vaexey/oracle/README.md

# oracle
PDA device concept  
  
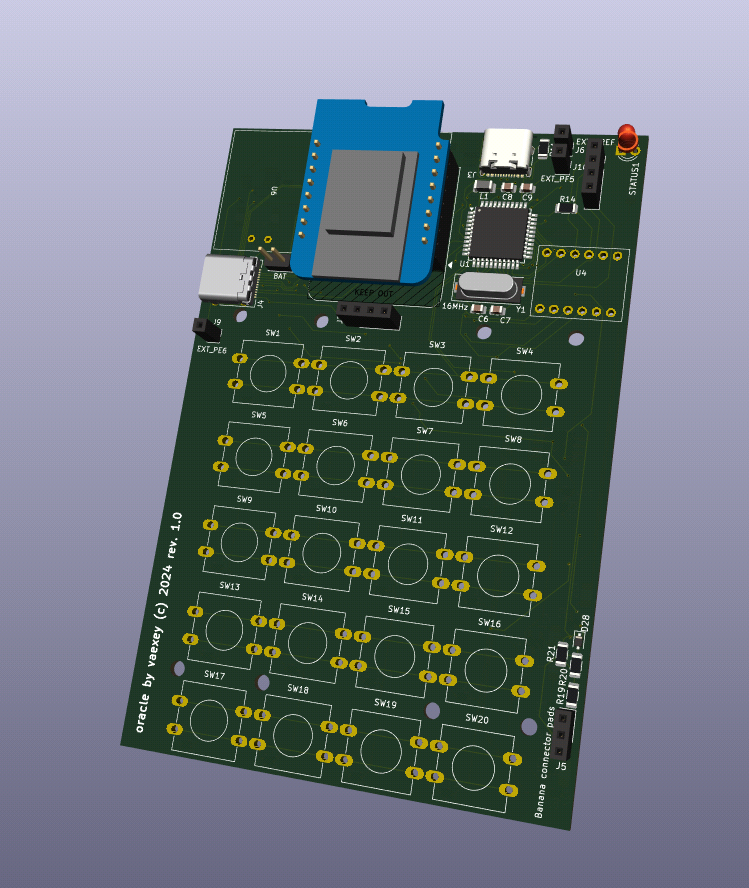
[picture p1: docs/oracle_3d_image.png]
3D image
  
  
`TODO: README`
