vaexey/oracle/docs/proprietary/SOURCE.md

# Proprietary datasheets
All files posted here are licensed under different license than the repository one.  
Seek for the licensing information at the respectful owners' side.  

## Datasheets
 - [ATmega32U4](https://ww1.microchip.com/downloads/en/devicedoc/atmel-7766-8-bit-avr-atmega16u4-32u4_datasheet.pdf)
 - [WEMOS D1 MINI schematic](https://www.wemos.cc/en/latest/_static/files/sch_d1_mini_v3.0.0.pdf)
 - [TI NE5532](https://www.ti.com/lit/ds/symlink/ne5532.pdf)
