vaexey/oracle/docs/keypad.pdf

1

2

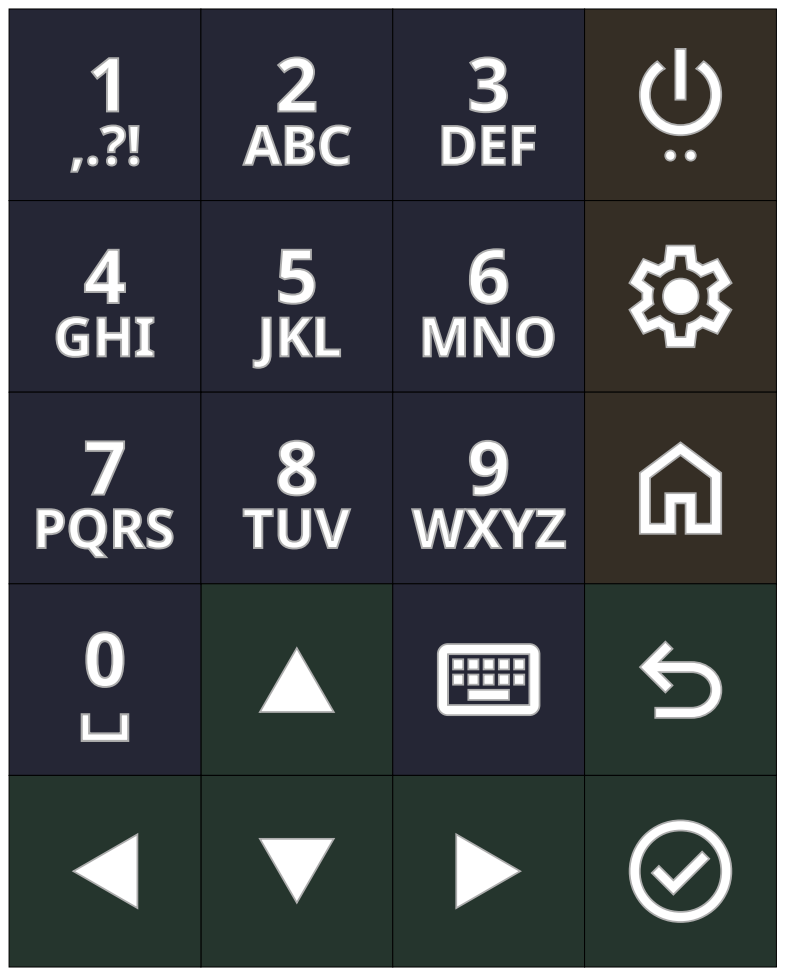
[picture p6: page 1]
ABC; 3 DEF; 4 GHI; 5 JKL; 6 MNO; 7 PQRS; 8 TUV; 9 WXYZ
