vaexey/oracle/docs/pcb_v.1.0.pdf

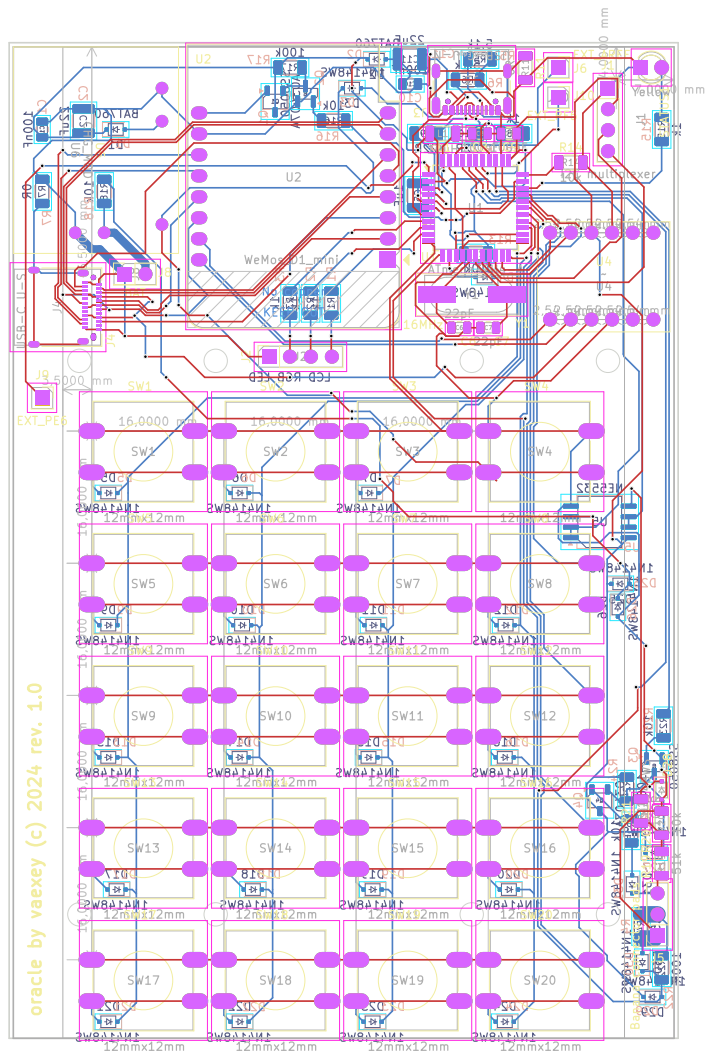
[picture p7: page 1]
