vaexey/oracle/oracle/oracle.kicad_pcb

## KiCad design oracle/oracle.kicad_pcb (2024-11-30)

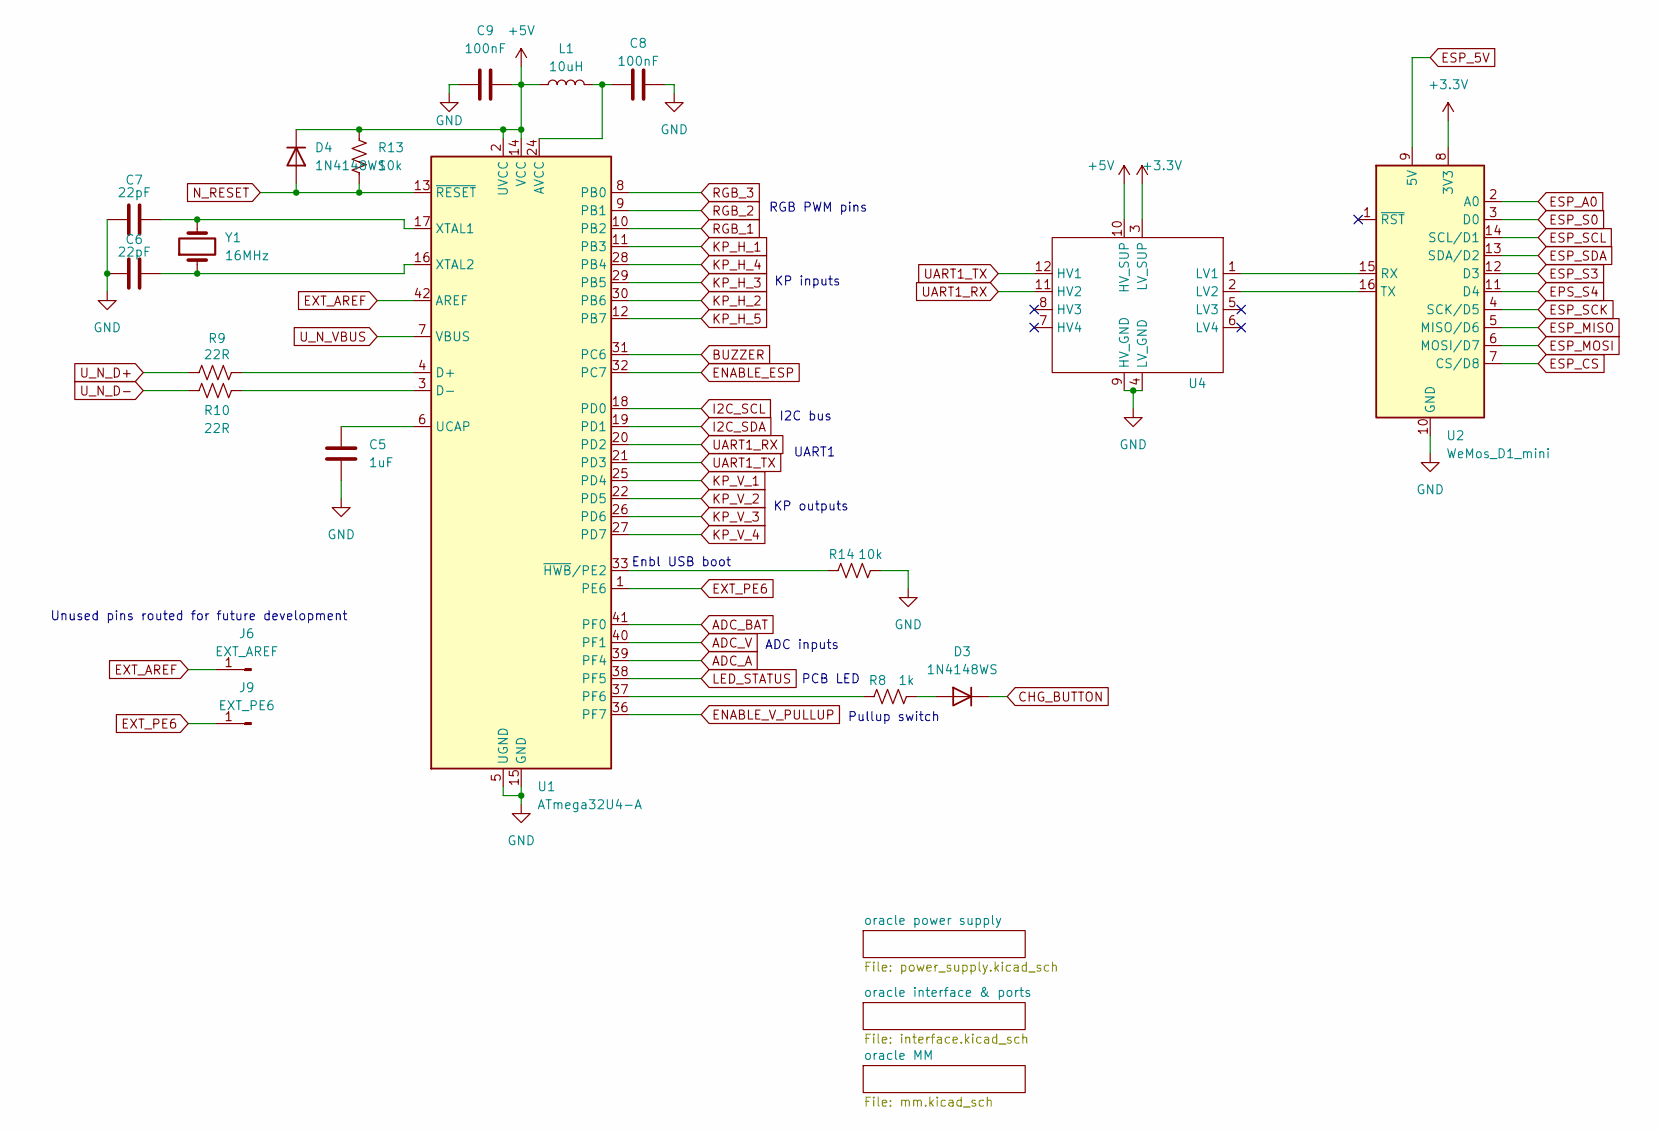
[picture p8: schematic oracle.kicad_sch, oracle root]

Parts:
C5: 1uF; C_1210_3225Metric
C6, C7: 22pF; C_0805_2012Metric
C8, C9: 100nF; C_0805_2012Metric
D3, D4: 1N4148WS; D_SOD-323F
J6: EXT_AREF; PinSocket_1x01_P2.54mm_Vertical
J9: EXT_PE6; PinSocket_1x01_P2.54mm_Vertical
L1: 10uH; L_1206_3216Metric
R8: 1k; R_1206_3216Metric
R9, R10: 22R; R_1206_3216Metric
R13, R14: 10k; R_1206_3216Metric
U1: ATmega32U4-A; TQFP-44_10x10mm_P0.8mm
U2: WeMos_D1_mini; WEMOS_D1_mini_light
U4: 4ch_level_shifter_v1
Y1: 16MHz; Crystal_SMD_HC49-SD

Connections:
+3.3V: U2.8 (3V3), U4.3 (LV_SUP)
+5V: C9.2, D4.1 (K), L1.1, R13.1, U1.2 (UVCC), U1.14 (VCC), U1.34 (VCC), U4.10 (HV_SUP); also elsewhere on the board
ADC_A: U1.39 (PF4); also elsewhere on the board
ADC_BAT: U1.41 (PF0); also elsewhere on the board
ADC_V: U1.40 (PF1); also elsewhere on the board
BUZZER: U1.31 (PC6); also elsewhere on the board
CHG_BUTTON: D3.1 (K); also elsewhere on the board
ENABLE_ESP: U1.32 (PC7); also elsewhere on the board
ENABLE_V_PULLUP: U1.36 (PF7); also elsewhere on the board
EPS_S4: U2.11 (D4); also elsewhere on the board
ESP_5V: U2.9 (5V); also elsewhere on the board
ESP_A0: U2.2 (A0); also elsewhere on the board
ESP_CS: U2.7 (CS/D8); also elsewhere on the board
ESP_MISO: U2.5 (MISO/D6); also elsewhere on the board
ESP_MOSI: U2.6 (MOSI/D7); also elsewhere on the board
ESP_S0: U2.3 (D0); also elsewhere on the board
ESP_S3: U2.12 (D3); also elsewhere on the board
ESP_SCK: U2.4 (SCK/D5); also elsewhere on the board
ESP_SCL: U2.14 (SCL/D1); also elsewhere on the board
ESP_SDA: U2.13 (SDA/D2); also elsewhere on the board
EXT_AREF: J6.1, U1.42 (AREF)
EXT_PE6: J9.1, U1.1 (PE6)
GND: C5.2, C6.1, C7.1, C8.2, C9.1, R14.2, U1.5 (UGND), U1.15 (GND), U1.23 (GND), U1.35 (GND), U1.43 (GND), U2.10 (GND), U4.4 (LV_GND), U4.9 (HV_GND); also elsewhere on the board
I2C_SCL: U1.18 (PD0); also elsewhere on the board
I2C_SDA: U1.19 (PD1); also elsewhere on the board
KP_H_1: U1.11 (PB3); also elsewhere on the board
KP_H_2: U1.30 (PB6); also elsewhere on the board
KP_H_3: U1.29 (PB5); also elsewhere on the board
KP_H_4: U1.28 (PB4); also elsewhere on the board
KP_H_5: U1.12 (PB7); also elsewhere on the board
KP_V_1: U1.25 (PD4); also elsewhere on the board
KP_V_2: U1.22 (PD5); also elsewhere on the board
KP_V_3: U1.26 (PD6); also elsewhere on the board
KP_V_4: U1.27 (PD7); also elsewhere on the board
LED_STATUS: U1.38 (PF5); also elsewhere on the board
N_RESET: D4.2 (A), R13.2, U1.13 (~RESET)
unnamed: C8.1, L1.2, U1.24 (AVCC), U1.44 (AVCC)
unnamed: D3.2 (A), R8.2
unnamed: R9.2, U1.4 (D+)
unnamed: R10.2, U1.3 (D-)
unnamed: R8.1, U1.37 (PF6)
unnamed: C5.1, U1.6 (UCAP)
unnamed: C7.2, U1.17 (XTAL1), Y1.2
unnamed: C6.2, U1.16 (XTAL2), Y1.1
unnamed: R14.1, U1.33 (~HWB/PE2)
unnamed: U2.15 (RX), U4.1 (LV1)
unnamed: U2.16 (TX), U4.2 (LV2)
RGB_1: U1.10 (PB2); also elsewhere on the board
RGB_2: U1.9 (PB1); also elsewhere on the board
RGB_3: U1.8 (PB0); also elsewhere on the board
UART1_RX: U1.20 (PD2), U4.11 (HV2)
UART1_TX: U1.21 (PD3), U4.12 (HV1)
U_N_D+: R9.1; also elsewhere on the board
U_N_D-: R10.1; also elsewhere on the board
U_N_VBUS: U1.7 (VBUS); also elsewhere on the board

Notes on the sheet:
RGB PWM pins
Pullup switch
ADC inputs
Unused pins routed for future development
I2C bus
KP outputs
KP inputs
UART1
PCB LED
Enbl USB boot

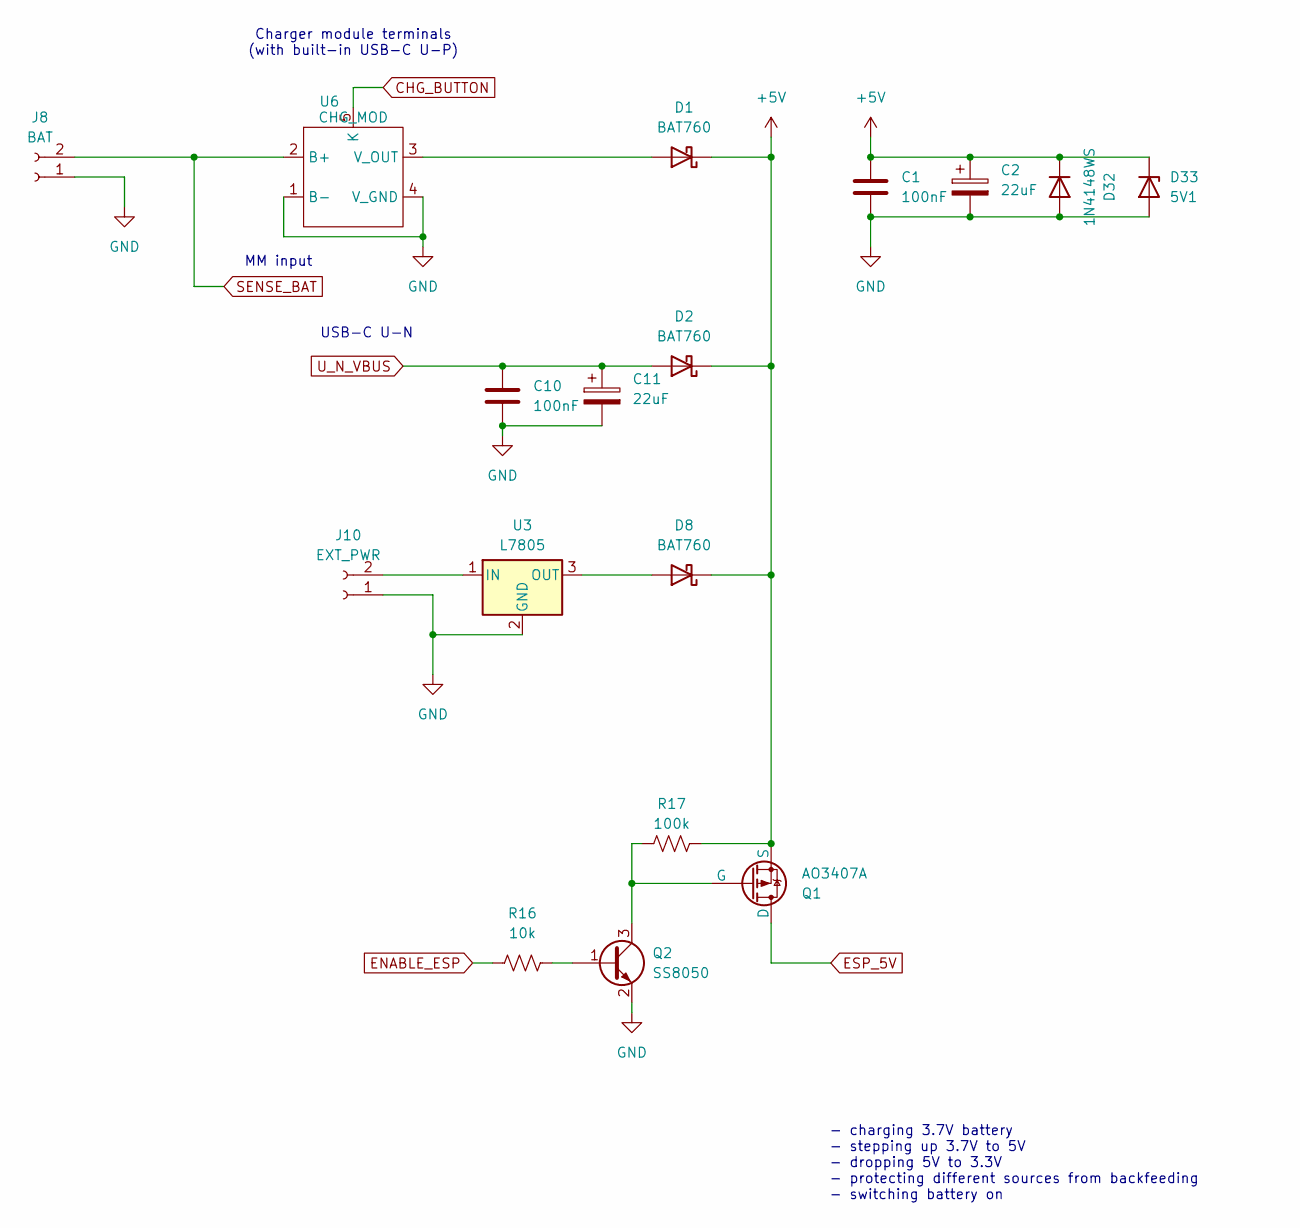
[picture p9: schematic power_supply.kicad_sch, power section]

Parts:
C1, C10: 100nF; C_0805_2012Metric
C2, C11: 22uF; C_1210_3225Metric
D1, D2, D8: BAT760; D_SOD-323F
D32: 1N4148WS; D_SOD-323F
D33: 5V1; D_DO-15_P10.16mm_Horizontal
J8: BAT; PinHeader_2x01_P2.54mm_Vertical
J10: EXT_PWR; PinHeader_2x01_P2.54mm_Vertical
Q1: AO3407A; TSOT-23
Q2: SS8050; SOT-23
R16: 10k; R_1206_3216Metric
R17: 100k; R_1206_3216Metric
U3: L7805; TO-252-2
U6: CHG_MOD; lipo_chg_module

Connections:
+5V: C1.1, C2.1, D1.1 (K), D2.1 (K), D8.1 (K), D32.1 (K), D33.1 (K), Q1.3 (S), R17.1; also elsewhere on the board
CHG_BUTTON: U6.5 (K); also elsewhere on the board
ENABLE_ESP: R16.2; also elsewhere on the board
ESP_5V: Q1.1 (D); also elsewhere on the board
GND: C1.2, C2.2, C10.2, C11.2, D32.2 (A), D33.2 (A), J8.1, J10.1, Q2.2 (E), U3.2 (GND), U6.1 (B-), U6.4 (V_GND); also elsewhere on the board
unnamed: D1.2 (A), U6.3 (V_OUT)
unnamed: D8.2 (A), U3.3 (OUT)
unnamed: J10.2, U3.1 (IN)
unnamed: Q1.2 (G), Q2.3 (C), R17.2
unnamed: Q2.1 (B), R16.1
SENSE_BAT: J8.2, U6.2 (B+); also elsewhere on the board
U_N_VBUS: C10.1, C11.1, D2.2 (A); also elsewhere on the board

Notes on the sheet:
- charging 3.7V battery - stepping up 3.7V to 5V - dropping 5V to 3.3V - protecting different sources from backfeeding - switching battery on
MM input
USB-C U-N
Charger module terminals (with built-in USB-C U-P)

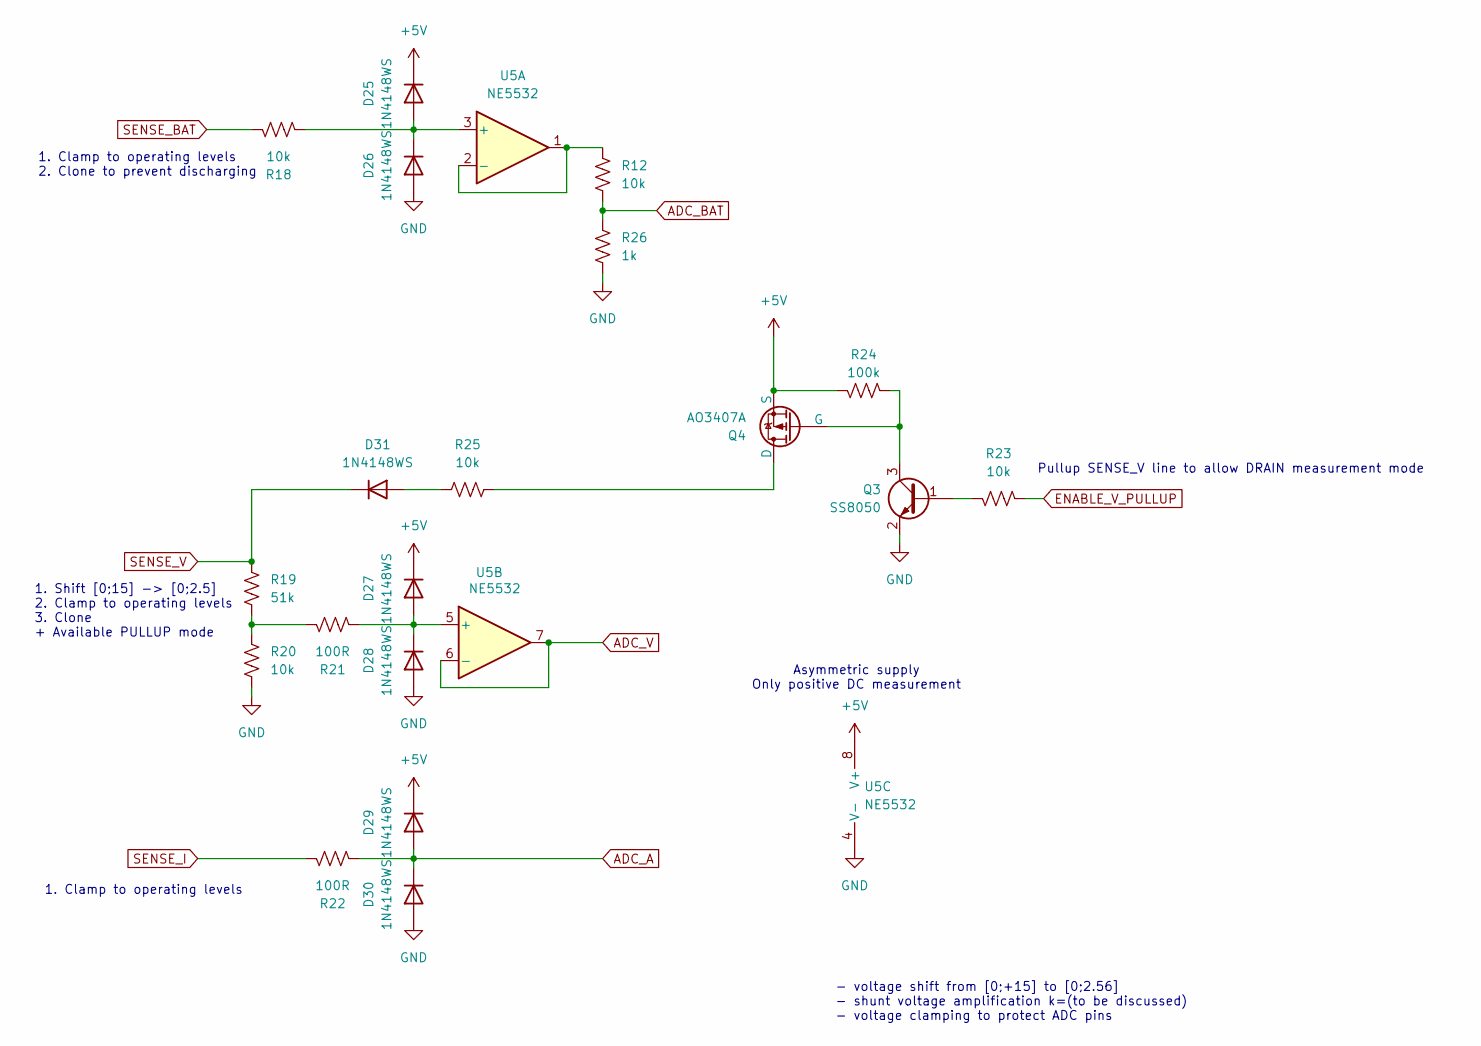
[picture p10: schematic mm.kicad_sch, measurement module (MM)]

Parts:
D25, D26, D27, D28, D29, D30, D31: 1N4148WS; D_SOD-323F
Q3: SS8050; SOT-23
Q4: AO3407A; TSOT-23
R12, R18, R20, R23, R25: 10k; R_1206_3216Metric
R19: 51k; R_1206_3216Metric
R21, R22: 100R; R_1206_3216Metric
R24: 100k; R_1206_3216Metric
R26: 1k; R_1206_3216Metric
U5: NE5532; SO-8_5.3x6.2mm_P1.27mm

Connections:
+5V: D25.1 (K), D27.1 (K), D29.1 (K), Q4.3 (S), R24.1, U5.8 (V+); also elsewhere on the board
ADC_A: D29.2 (A), D30.1 (K), R22.2; also elsewhere on the board
ADC_BAT: R12.2, R26.1; also elsewhere on the board
ADC_V: U5.6 (-), U5.7; also elsewhere on the board
ENABLE_V_PULLUP: R23.2; also elsewhere on the board
GND: D26.2 (A), D28.2 (A), D30.2 (A), Q3.2 (E), R20.2, R26.2, U5.4 (V-); also elsewhere on the board
unnamed: D25.2 (A), D26.1 (K), R18.2, U5.3 (+)
unnamed: D27.2 (A), D28.1 (K), R21.2, U5.5 (+)
unnamed: D31.2 (A), R25.1
unnamed: Q3.1 (B), R23.1
unnamed: Q3.3 (C), Q4.2 (G), R24.2
unnamed: Q4.1 (D), R25.2
unnamed: R19.2, R20.1, R21.1
unnamed: R12.1, U5.1, U5.2 (-)
SENSE_BAT: R18.1; also elsewhere on the board
SENSE_I: R22.1; also elsewhere on the board
SENSE_V: D31.1 (K), R19.1; also elsewhere on the board

Notes on the sheet:
1. Clamp to operating levels 2. Clone to prevent discharging
1. Clamp to operating levels
1. Shift [0;15] -> [0;2.5] 2. Clamp to operating levels 3. Clone + Available PULLUP mode
- voltage shift from [0;+15] to [0;2.56] - shunt voltage amplification k=(to be discussed) - voltage clamping to protect ADC pins
Pullup SENSE_V line to allow DRAIN measurement mode
Asymmetric supply Only positive DC measurement

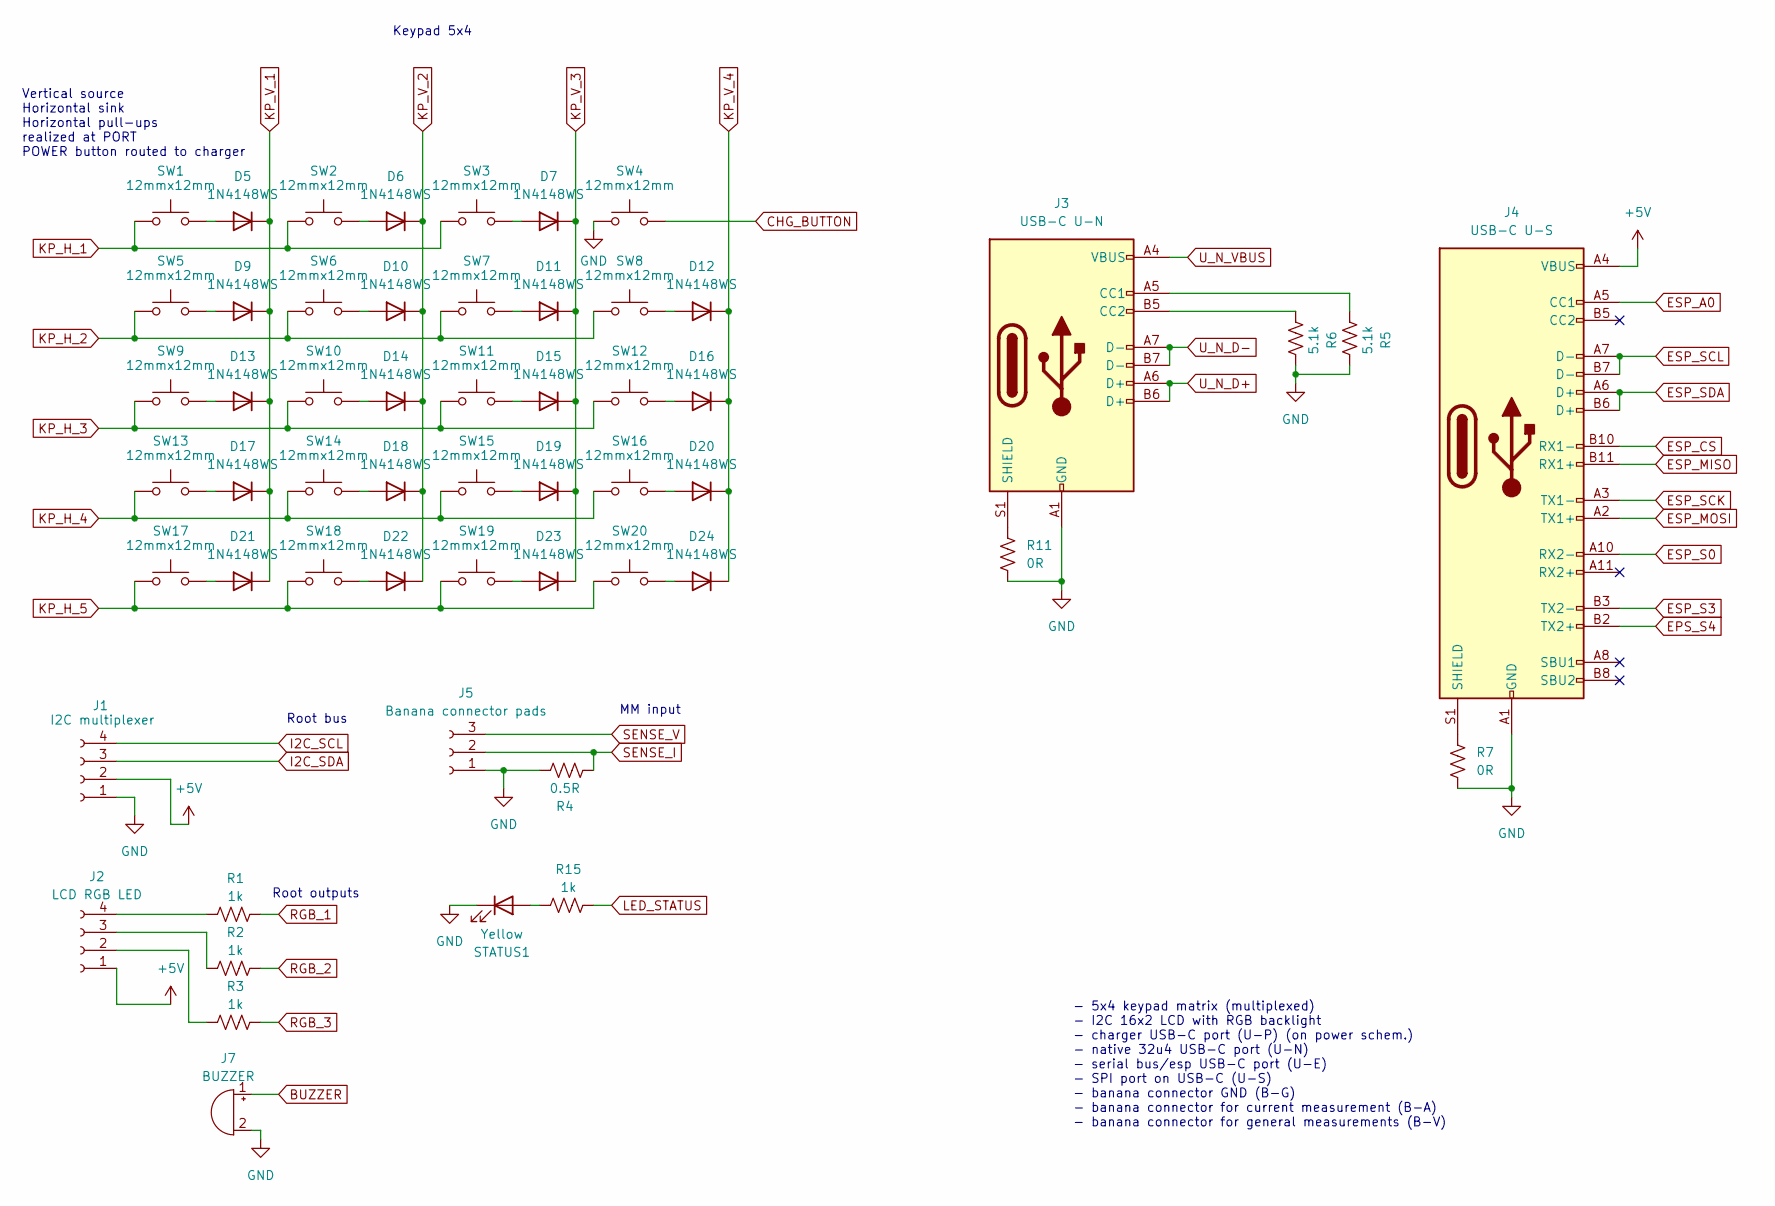
[picture p11: schematic interface.kicad_sch, interface & ports]

Parts:
D5, D6, D7, D9, D10, D11, D12, D13, D14, D15, D16, D17, D18, D19, D20, D21, D22, D23, D24: 1N4148WS; D_SOD-323F
J1: I2C multiplexer; PinSocket_1x04_P2.54mm_Vertical
J2: LCD RGB LED; PinSocket_1x04_P2.54mm_Vertical
J3: USB-C U-N; USB_C_Receptacle_GCT_USB4105-xx-A_16P_TopMnt_Horizontal
J4: USB-C U-S; USB_C_Receptacle_Amphenol_12401548E4-2A
J5: Banana connector pads; PinSocket_1x03_P2.54mm_Vertical
J7: BUZZER; PinHeader_1x02_P2.54mm_Vertical
R1, R2, R3, R15: 1k; R_1206_3216Metric
R4: 0.5R; R_1206_3216Metric
R5, R6: 5.1k; R_1206_3216Metric
R7, R11: 0R; R_1206_3216Metric
STATUS1: Yellow; LED_D3.0mm
SW1, SW2, SW3, SW4, SW5, SW6, SW7, SW8, SW9, SW10, SW11, SW12, SW13, SW14, SW15, SW16, SW17, SW18, SW19, SW20: 12mmx12mm; SW_PUSH-12mm

Connections:
+5V: J1.2, J2.1, J4.A4 (VBUS), J4.A9 (VBUS), J4.B4 (VBUS), J4.B9 (VBUS); also elsewhere on the board
BUZZER: J7.1 (+); also elsewhere on the board
CHG_BUTTON: SW4.2; also elsewhere on the board
EPS_S4: J4.B2 (TX2+); also elsewhere on the board
ESP_A0: J4.A5 (CC1); also elsewhere on the board
ESP_CS: J4.B10 (RX1-); also elsewhere on the board
ESP_MISO: J4.B11 (RX1+); also elsewhere on the board
ESP_MOSI: J4.A2 (TX1+); also elsewhere on the board
ESP_S0: J4.A10 (RX2-); also elsewhere on the board
ESP_S3: J4.B3 (TX2-); also elsewhere on the board
ESP_SCK: J4.A3 (TX1-); also elsewhere on the board
ESP_SCL: J4.A7 (D-), J4.B7 (D-); also elsewhere on the board
ESP_SDA: J4.A6 (D+), J4.B6 (D+); also elsewhere on the board
GND: J1.1, J3.A1 (GND), J3.A12 (GND), J3.B1 (GND), J3.B12 (GND), J4.A1 (GND), J4.A12 (GND), J4.B1 (GND), J4.B12 (GND), J5.1, J7.2 (-), R4.2, R5.2, R6.2, R7.2, R11.2, STATUS1.1 (K), SW4.1; also elsewhere on the board
I2C_SCL: J1.4; also elsewhere on the board
I2C_SDA: J1.3; also elsewhere on the board
KP_H_1: SW1.1, SW2.1, SW3.1; also elsewhere on the board
KP_H_2: SW5.1, SW6.1, SW7.1, SW8.1; also elsewhere on the board
KP_H_3: SW9.1, SW10.1, SW11.1, SW12.1; also elsewhere on the board
KP_H_4: SW13.1, SW14.1, SW15.1, SW16.1; also elsewhere on the board
KP_H_5: SW17.1, SW18.1, SW19.1, SW20.1; also elsewhere on the board
KP_V_1: D5.1 (K), D9.1 (K), D13.1 (K), D17.1 (K), D21.1 (K); also elsewhere on the board
KP_V_2: D6.1 (K), D10.1 (K), D14.1 (K), D18.1 (K), D22.1 (K); also elsewhere on the board
KP_V_3: D7.1 (K), D11.1 (K), D15.1 (K), D19.1 (K), D23.1 (K); also elsewhere on the board
KP_V_4: D12.1 (K), D16.1 (K), D20.1 (K), D24.1 (K); also elsewhere on the board
LED_STATUS: R15.2; also elsewhere on the board
unnamed: D5.2 (A), SW1.2
unnamed: D6.2 (A), SW2.2
unnamed: D7.2 (A), SW3.2
unnamed: D9.2 (A), SW5.2
unnamed: D10.2 (A), SW6.2
unnamed: D11.2 (A), SW7.2
unnamed: D12.2 (A), SW8.2
unnamed: D13.2 (A), SW9.2
unnamed: D14.2 (A), SW10.2
unnamed: D15.2 (A), SW11.2
unnamed: D16.2 (A), SW12.2
unnamed: D17.2 (A), SW13.2
unnamed: D18.2 (A), SW14.2
unnamed: D19.2 (A), SW15.2
unnamed: D20.2 (A), SW16.2
unnamed: D21.2 (A), SW17.2
unnamed: D22.2 (A), SW18.2
unnamed: D23.2 (A), SW19.2
unnamed: D24.2 (A), SW20.2
unnamed: J2.2, R3.1
unnamed: J2.3, R2.1
unnamed: J2.4, R1.1
unnamed: J3.A5 (CC1), R5.1
unnamed: J3.B5 (CC2), R6.1
unnamed: J3.S1 (SHIELD), R11.1
unnamed: J4.S1 (SHIELD), R7.1
unnamed: R15.1, STATUS1.2 (A)
RGB_1: R1.2; also elsewhere on the board
RGB_2: R2.2; also elsewhere on the board
RGB_3: R3.2; also elsewhere on the board
SENSE_I: J5.2, R4.1; also elsewhere on the board
SENSE_V: J5.3; also elsewhere on the board
U_N_D+: J3.A6 (D+), J3.B6 (D+); also elsewhere on the board
U_N_D-: J3.A7 (D-), J3.B7 (D-); also elsewhere on the board
U_N_VBUS: J3.A4 (VBUS), J3.A9 (VBUS), J3.B4 (VBUS), J3.B9 (VBUS); also elsewhere on the board

Notes on the sheet:
Root bus
Root outputs
- 5x4 keypad matrix (multiplexed) - I2C 16x2 LCD with RGB backlight - charger USB-C port (U-P) (on power schem.) - native 32u4 USB-C port (U-N) - serial bus/esp USB-C port (U-E) - SPI port on USB-C (U-S) - banana connector GND (B-G) - banana connector for current measurement (B-A) - banana connecto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
MM input
Vertical source Horizontal sink Horizontal pull-ups realized at PORT POWER button routed to charger
Keypad 5x4

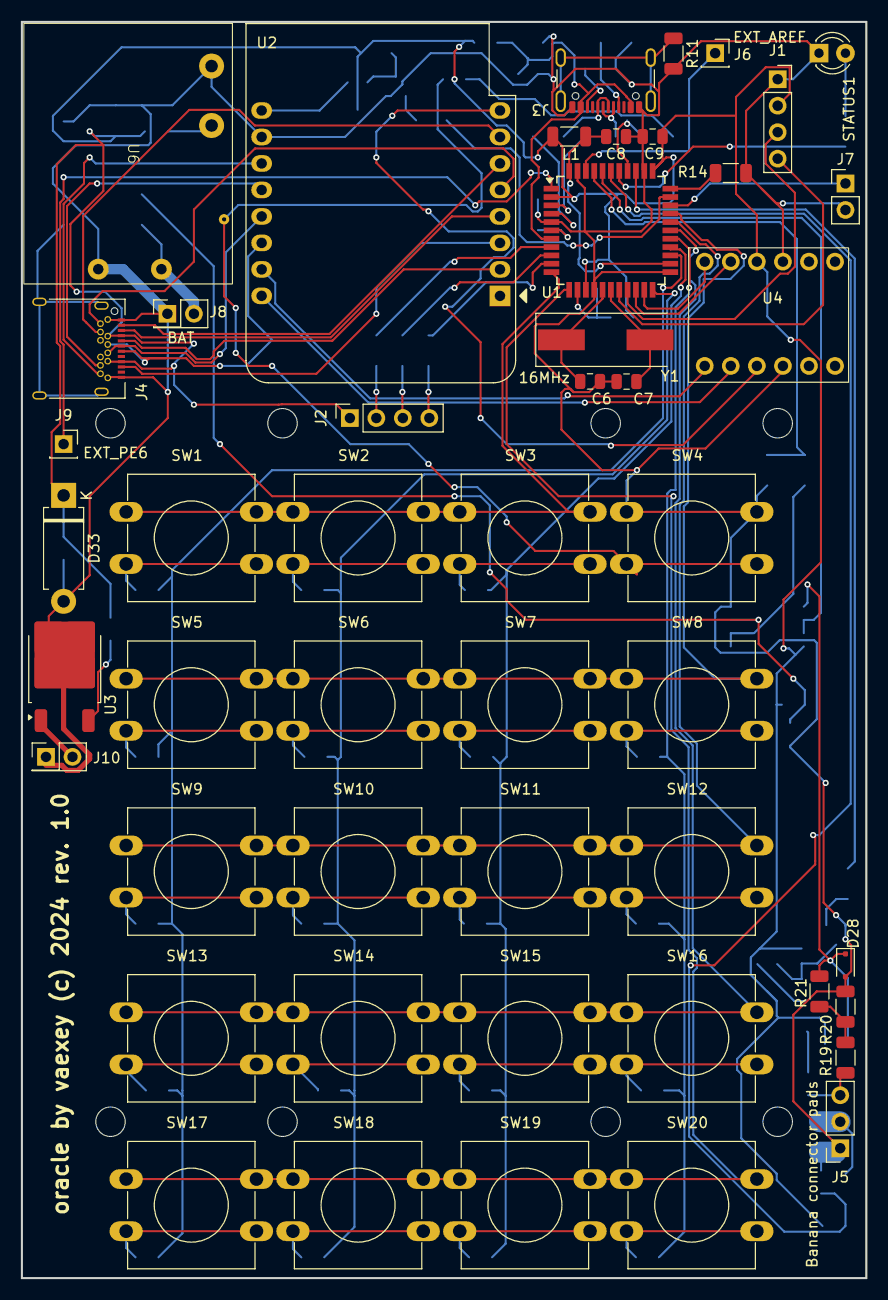
[picture p12: board oracle.kicad_pcb from above]

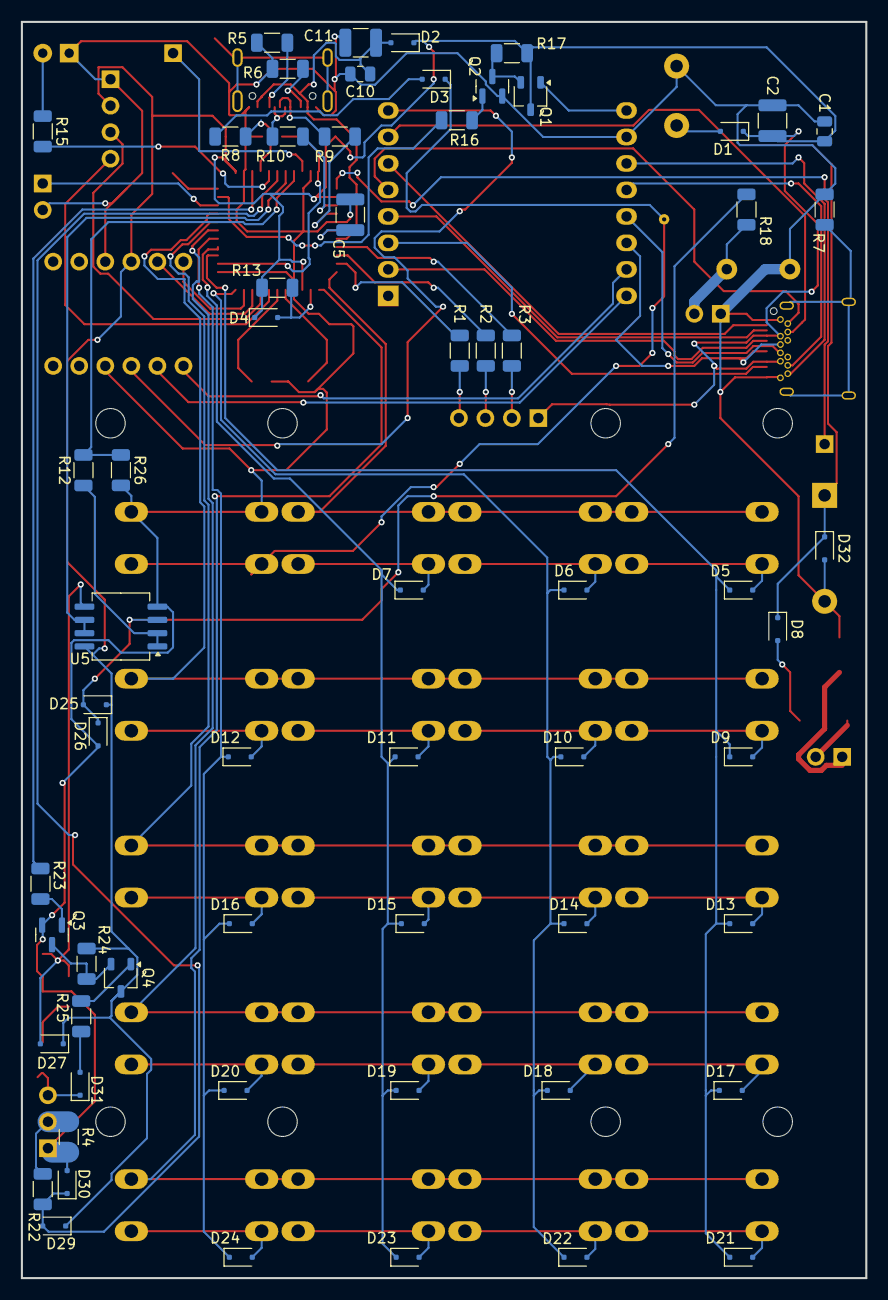
[picture p13: board oracle.kicad_pcb from below]

Board: 2 copper layers, 81.0 x 120.5 mm, 111 parts (62 on the bottom side), 98 nets.
