vaexey/oracle/src/e_core/src/apps/meter.hpp

#pragma once
#include "app.hpp"

namespace apps
{
    class meter : public app
    {
    public:
        void setup();
        void loop();
        void setdown();
        void on_key_down(int key);

    private:
        bool pullup;
    };

} // namespace apps
