vaexey/oracle/src/n_core/src/esp.hpp

#ifndef N_CORE_ESP
#define N_CORE_ESP

#include <Arduino.h>

/**
 * Macro for debug mode that:
 *  - does not require BOOT message (thus no wdt timeout)
 *  - uses USB Serial rather than onboard TX/RX (ESP) Serial
 */
// #define NO_ESP

#ifndef NO_ESP
#define ESP_SERIAL Serial1
#else
#define ESP_SERIAL Serial
#endif


namespace esp
{
    void setup();
    void loop();

    void setProgrammingMode();

    void capture_serial();

    void onProgrammingButton(bool value);

} // namespace esp

#endif
