vaexey/oracle/(commit log)

2024-11-12 Project init
    [interface.kicad_sch, mm.kicad_sch, oracle.kicad_pcb, oracle.kicad_sch, power_supply.kicad_sch]
2024-11-30 add n_core firmware add e_core firmware stub update PCB
    [interface.kicad_sch, mm.kicad_sch, oracle.kicad_pcb, oracle.kicad_sch, power_supply.kicad_sch]
2025-01-16 add e_core sample apps add keypad svg minor integration changes
