vaexey/oracle/(notices)

Notices in the files:
oracle/oracle.kicad_pcb:
oracle by vaexey (c) 2024 rev. 1.0
